khanhnm08/HK_Egg_Incubator/Image/z2520415236812_bf9dbb3cffaa10acfa7b76b04709e803.jpg

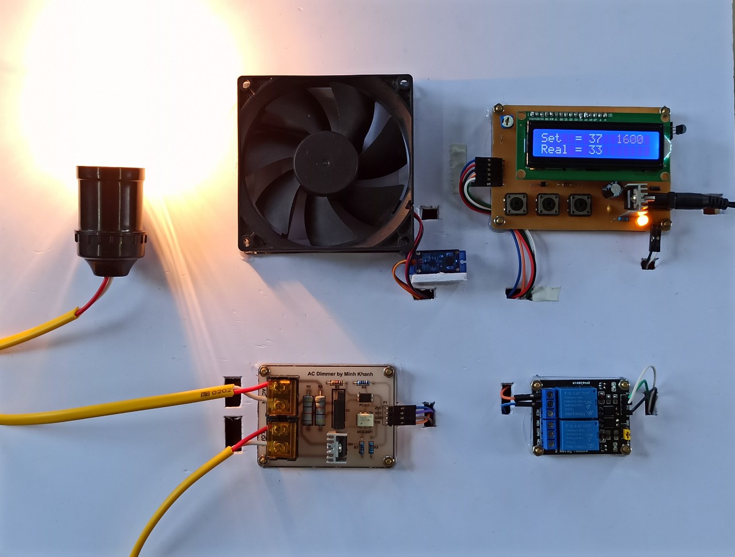
Image/z2520415236812_bf9dbb3cffaa10acfa7b76b04709e803.jpg
