khanhnm08/HK_Egg_Incubator/Image/z2520414831930_501c888e308c328f4274072a1150b6d0.jpg

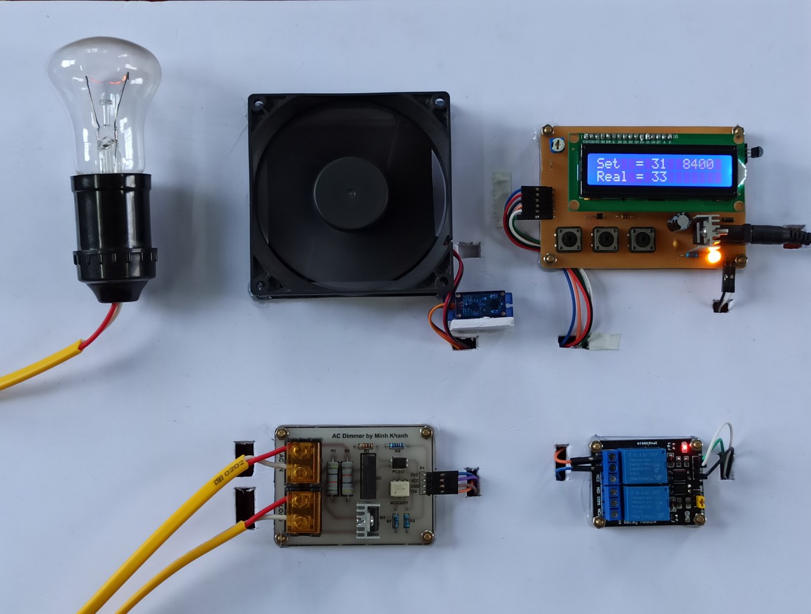
Image/z2520414831930_501c888e308c328f4274072a1150b6d0.jpg
