khanhnm08/HK_Egg_Incubator/README.md

# Điều khiển nhiệt dộ ứng dụng cho lò ấm trứng.
