khanhnm08/HK_Egg_Incubator/Slide bao cao.pptx

## Điều khiển nhiệt độ ứng dụng cho lò ấp trứng.

Ngô Minh Khánh – 18020698
Đặng Trung Hiếu – 18020498

## Nội dung

I. Mở đầu

II. Sơ lược hệ thống

III.Chi tiết các chức năng chính.

IV. Tổng kết & đánh giá

## Slide 3

I. Mở đầu.

- Đề tài hướng tới xây dựng hệ thống tự động kiểm soát nhiệt độ của lò ấp trứng. Trong thực tế hiện nay các bác nông dẫn sử dụng phương pháp truyền thống hoặc các mạch relay để làm lò ấp, các phương pháp này đem lại khả năng ổn định nhiệt độ không cao do đó nhóm chúng em đã nảy ra ý tưởng thực hiện đề tài này.

- Các yêu cầu chức năng chính:
- Đo đạc nhiệt độ.
- Hiện thị thông số nhiệt độ.
- Điều chỉnh thiết bị gia nhiệt dùng thuật toán PID số.
- Tính năng thông gió.

## Slide 4

II. Sơ lược hệ thống.

1. Sơ đồ khối thành phần hệ thống.


## Slide 5

II. Sơ lược hệ thống.

2. Mạch nguyên lý.

- Các thành phần quan trọng:
- LM35
- AC dimmer
- Relay
- Servo


## Slide 6

II. Sơ lược hệ thống.

3. Lưu đồ thuật toán tổng quát.


## Slide 7

III. Chi tiết các chức năng chính.

1. Đọc giá trị nhiệt độ LM35.

1.1. Cảm biến nhiệt độ LM35.

- LM35 là một loại cảm biến nhiệt độ bán dẫn tương tự rất phổ biến và được ứng dụng rất nhiều trong thực tế hiện nay. Nhiệt độ được xác định bằng cách đo hiệu điện thế ngõ ra và không cần căn chỉnh.
- Điện áp ngõ ra thay đổi tuyến tính: 10mV/°C


## Slide 8

III. Chi tiết các chức năng chính.

1. Đọc giá trị nhiệt độ LM35.

1.2. Chương trình.

a, Cấu hình ADC.


b, Đọc nhiệt độ.

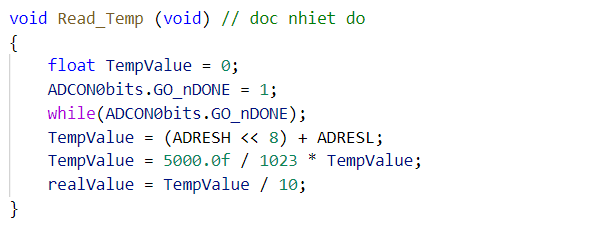
[picture p28: figure]

## Slide 9

III. Chi tiết các chức năng chính.

2. Điều chỉnh cường độ bóng đèn gia nhiệt.

2.1. Mạch AC dimmer.

a, Mạch kích Triac (Khung xanh).

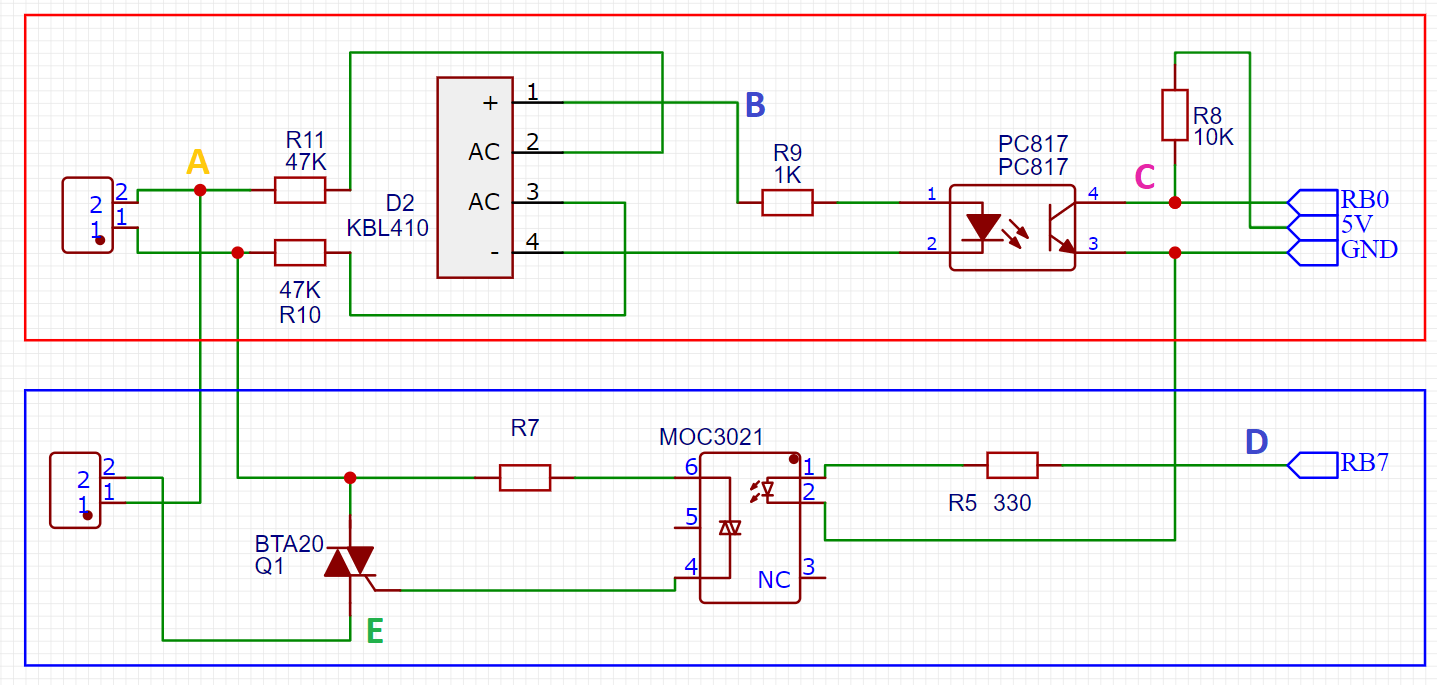
[picture p29: figure]
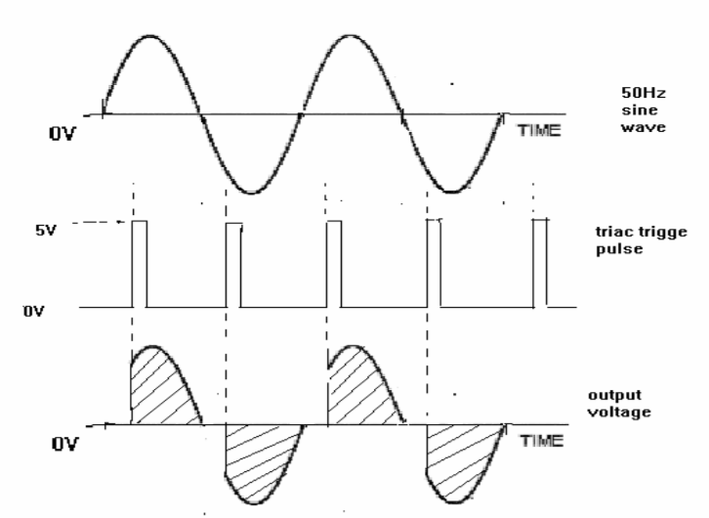
[picture p30: figure]

- Khi VĐK kích 1 ra MOC3021, diode quang trong MOC3021 sáng kích thích Diac bên trong thông, dẫn dòng điện điện từ chân T2 của Triac BTA20 đến chân G làm Triac thông.

A

AC_IN

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
LOAD

A: Điện áp xoay chiều 220V.

D: Điện áp kích Triac.

E: Dòng điện qua triac điều khiển đèn.

## Slide 10

III. Chi tiết các chức năng chính.

2. Điều chỉnh cường độ bóng đèn gia nhiệt.

2.1. Mạch AC dimmer.

b, Mạch phát hiện điểm 0 (Khung đỏ).


Tín hiệu tại C là là tín hiệu ngắt để VĐK nhận biết được điểm 0 trong nguồn điện ở đâu, đưa ra tín hiệu ổn định chính xác.

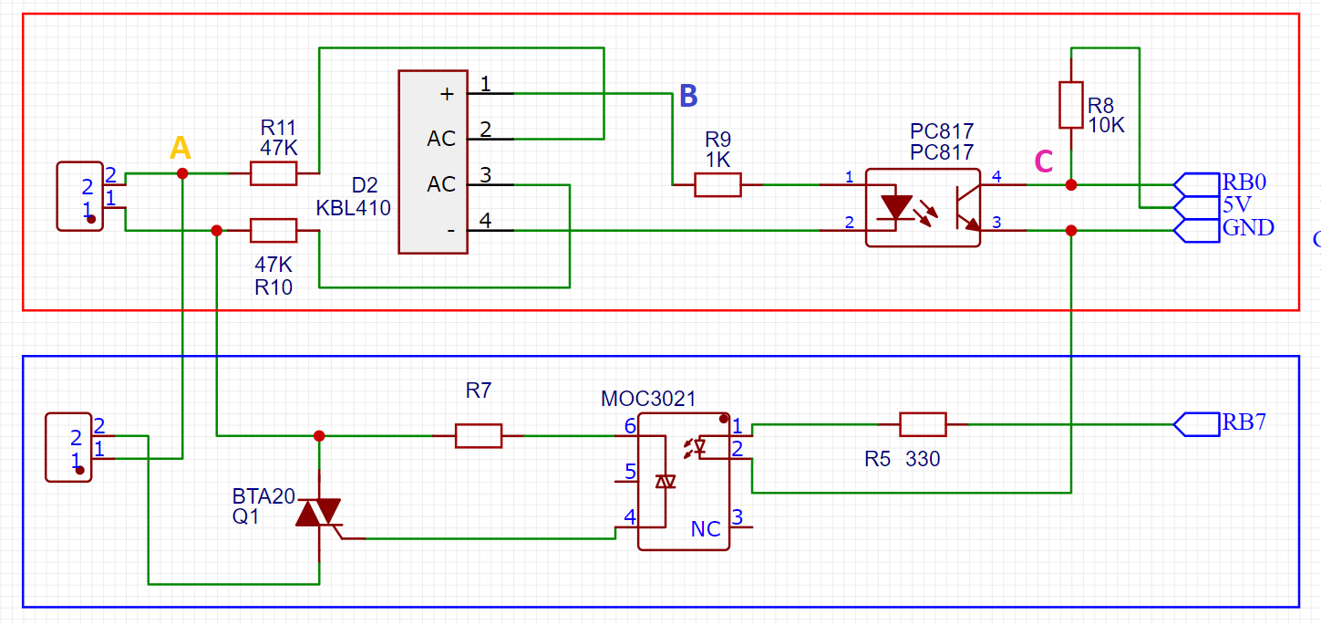
[picture p31: figure]

AC_IN

T2

T1

LOAD

G

A: Điện áp xoay chiều 220V.

B: Điện áp sau khi qua cầu diode KBL410.

C: Xung báo hiệu điểm 0.

## Slide 11

III. Chi tiết các chức năng chính.

2. Điều chỉnh cường độ bóng đèn gia nhiệt.

2.2. Chương trình.

a, Công thức PID số:

Trong đó:
- Kp: độ lợi tỉ lệ
- Ki: độ lợi tích phân
- Kd: độ lợi vi phân
- T: Thời gian lấy mẫu
- ek: Sai số của giá trị setPoint và realValue
- uk: Thông số đưa ra để điểu khiển.

*Trích từ slide bài giảng PID số, TS. Phạm Duy Hưng – UET, VNU.

## Slide 12

III. Chi tiết các chức năng chính.

2. Điều chỉnh cường độ bóng đèn gia nhiệt.

2.2. Chương trình.

b, Code.

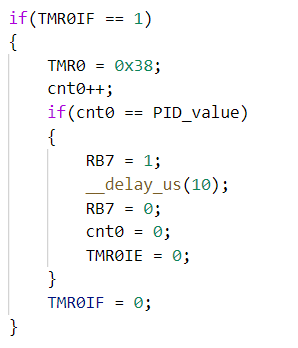
[picture p32: figure]

3. Timer 0 được cài đặt interrupt mỗi 100us. Khi cnt0 đạt giá trị bằng PID_value, kích Triac và Disable Timer 0.

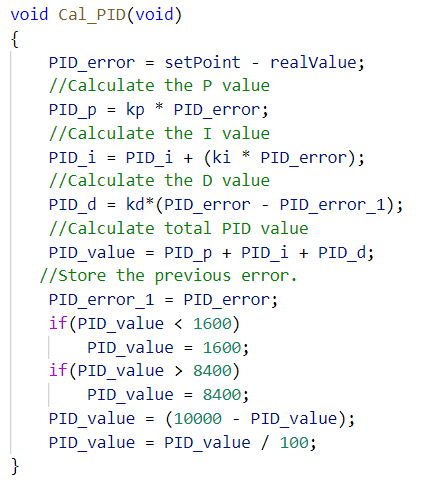
[picture p33: figure]

1. Tính lại giá trị PID sau mỗi 1s (sử dụng timer 2 lấy mẫu).
*Nửa chu kỳ điện xoay chiều có thời gian là 1000us.

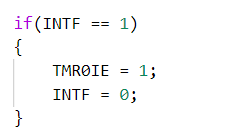
[picture p34: figure]

2. Enable Timer 0 khi phát hiện điểm 0.

## Slide 13

III. Chi tiết các chức năng chính.

3. Điều khiển quạt thông gió.

3.1. Mạch relay.

- RB6 = 0, Q2 thông, dòng điện qua cuộn dây, gây ra lực từ hút chân COM từ NC chuyển sang NO.

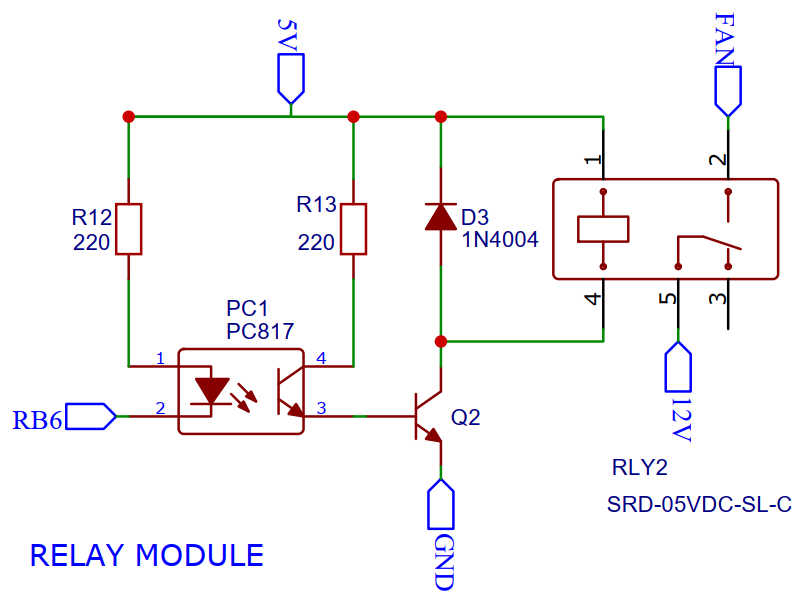
[picture p35: figure]

## Slide 14

III. Chi tiết các chức năng chính.

3. Điều khiển quạt thông gió.

3.2. Chương trình.

a, Cấu hình OUTPUT cho chân RB6.

b, Bật/tắt relay theo điều kiện.

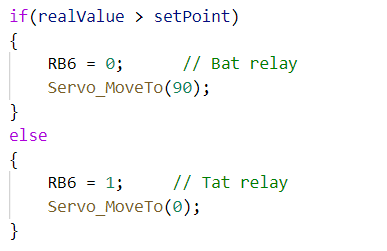
[picture p36: figure]

## Slide 15

III. Chi tiết các chức năng chính.

4. Điều khiển cửa thông gió.

4.1. Nguyên lý servo.

- Servo SG90 được điều khiển bằng băm xung. Tùy thuộc vào duty cycle, mà servo quay góc khác nhau.


## Slide 16

III. Chi tiết các chức năng chính.

4. Điều khiển cửa thông gió.

4.2. Chương trình.

- Đặt vấn đề.

Với Fosc = 16MHz, PR2 = 255 (8bit), Timer2 prescale (max) = 16. Tpwm = 1ms << 20ms. ==> Sử dụng Compare mode.

- Cài đặt chu kỳ bằng Timer 1

- SG90 có chu kỳ 20ms
- Tần số thạch anh = 16MHz => Tần số PIC, f = 4MHz
- Chọn prescale = 1:4
- Chu kỳ cho 1 tick = 1/(f/4) = 1us
- Cần tạo ra 20ms, ta cần 20000 tick
- Đặt preload cho Timer 1 = 65536 – 20000 = 45536 (0xB1E6)

- Điều chỉnh duty bằng CCPR1.

- Khi giá trị trên Timer 1 = CCPR1 -> RC2 =0.
- Servo quay góc 0 độ: CPPR1 = 0xB430.
- Servo quay góc 90 độ: CCPR1 = 0xB7A8.

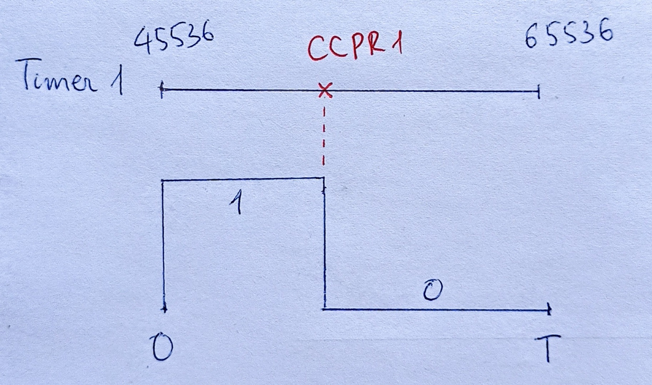
[picture p37: figure]

RC2

## Slide 17

III. Chi tiết các chức năng chính.

4. Điều khiển cửa thông gió.

4.2. Chương trình.

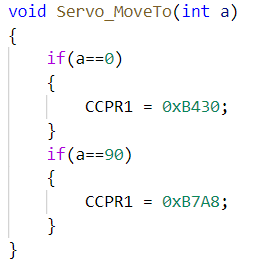
[picture p38: figure]

3. Điều chỉnh duty cycle.

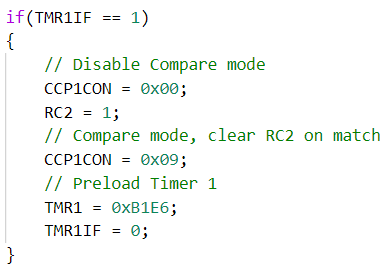
[picture p39: figure]

4. Đặt RC2 lên 1, preload lại Timer 1, đặt lại chế độ compare khi kết thúc 1 chu kỳ (Timer 1 interrupt)

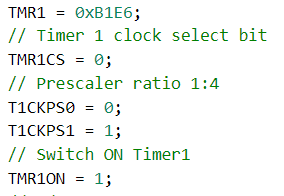
[picture p40: figure]

1. Cấu hình Timer 1
Tạo chu kỳ 20ms.

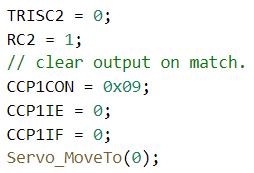
[picture p41: figure]

2. Cấu hình cho compare mode.
Xóa RC2 về 0 khi gí trị trên Timer 1 = CCPR1.

## Slide 18

IV. Tổng kết & đánh giá.

1.Demo video.

## Slide 19

IV. Tổng kết & đánh giá.

2. Đáp ứng hệ thống.

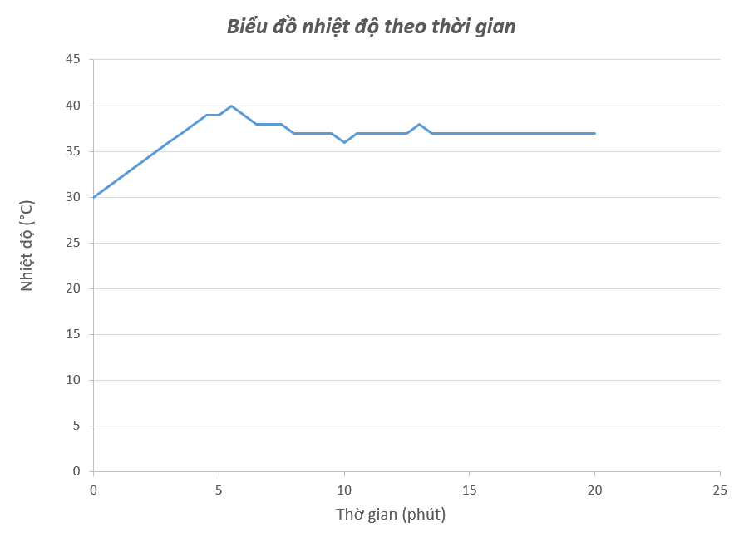
[picture p42: figure]

Đáp ứng hệ thống với nhiệt độ cài đặt 37°C và nhiệt độ ban đầu 30°C.

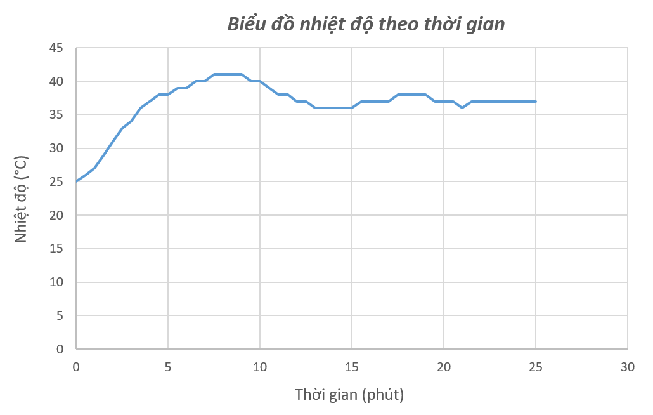
[picture p43: figure]

Đáp ứng hệ thống với nhiệt độ cài đặt 37°C nhiệt độ ban đầu 25°C.

## Slide 20

IV. Tổng kết & đánh giá.

3. Đánh giá.

- Ưu điểm:
- Hệ thộng hoạt động ổn định.
- Khả năng ổn định nhiệt độ tốt hơn so với phương pháp truyền thống (cắm bóng điện) và điều khiển on/off bằng relay.
- Nhược điểm:
- Cần thiết kế lại mạch để áp dụng trực tiếp vào thực tiễn.
- Cần khảo sát thêm giá trị PID để ổn định với khoảng chênh lệch nhiệt độ lớn hơn.

## Slide 21

THANK YOU!

Github: https://github.com/KhanhNgo19/HK_Egg_Incubator

## Slide 22

## Light Bulb Infographics

It’s a gas giant and also the biggest planet in the Solar System

Saturn is the ringed one. It’s composed mostly of hydrogen and helium

It has a beautiful name, but it’s terribly hot, even more than Mercury

Mercury is the closest planet to the Sun and the smallest one

Mars is actually a cold place. It’s a planet full of iron oxide dust

Neptune is the farthest planet from the Sun and the fourth-largest

## Light Bulb Infographics

Jupiter is a gas giant and actually also the biggest planet in the Solar System. It is the fourth-brightest object in the sky

1

2

Saturn is a gas giant in the Solar System, composed mostly of hydrogen and helium.
Yes, this is the ringed one

Venus has a beautiful name and is the second planet from the Sun. It’s terribly hot and its atmosphere is extremely poisonous

3

## Light Bulb Infographics

Mercury is the smallest planet in the Solar System

01

Jupiter is the biggest planet in the Solar System

02

Saturn is composed mostly of hydrogen and helium

03

Mars is actually a cold place. It’s full of iron oxide dust

04

## Light Bulb Infographics

It is the smallest planet in
the Solar System

Mercury

It is composed mostly of
hydrogen and helium

Saturn

It has a beautiful name,
but it is terribly hot

Venus

It is the biggest planet
in the Solar System

Jupiter

It is actually a cold place.
It’s full of iron oxide dust

Mars

## Light Bulb Infographics

01

Jupiter is the biggest planet in the Solar System

02

Mercury is the closest planet
to the Sun

03

Venus has a beautiful name, also high temperatures

04

Saturn is composed mostly of hydrogen and helium

05

Despite being red, Mars is actually
a cold place

## Light Bulb Infographics

Jupiter is the biggest planet in the Solar System

Saturn is composed mostly of hydrogen and helium

Venus has a beautiful name, also high temperatures

Despite being red, Mars is actually
a cold place

## Light Bulb Infographics

Jupiter is a gas giant and the biggest planet in the Solar System. It’s the fourth-brightest object in the sky

Saturn is a gas giant in the Solar System, composed mostly of hydrogen and helium. Yes, It’s the ringed one

Venus has a beautiful name, but it’s terribly hot. It’s the second planet from the Sun in the Solar System

## Light Bulb Infographics

01

04

02

03

Jupiter is a gas giant and also the biggest planet in the Solar System

It has a beautiful name, but it’s terribly hot, even hotter than Mercury

Mars is actually a cold place. It’s a planet full of iron oxide dust

It’s the smallest and closest planet to the Sun in the Solar System

## Light Bulb Infographics

Saturn is a gas giant in the Solar System, composed of hydrogen and helium

Venus has a beautiful name, and is the second planet from the Sun

Despite being red, Mars is actually a cold place. It’s full of iron oxide dust

Jupiter is a gas giant and actually also the biggest planet in the Solar System

## Light Bulb Infographics

It’s a gas giant and also the biggest planet in the Solar System

Saturn is the ringed one. It’s composed mostly of hydrogen and helium

It has a beautiful name, but it’s terribly hot, even more than Mercury

Mercury is the closest planet to the Sun and the smallest one

Mars is actually a cold place. It’s a planet full of iron oxide dust

It has a beautiful name and is the second planet from the Sun

## Light Bulb Infographics

Mercury is the closest planet to the Sun and the smallest one

Saturn is composed of hydrogen and helium. It’s the ringed one

Venus has the most beautiful name and is the second planet

Mars is actually a cold place. It’s a planet full of iron oxide dust

## Light Bulb Infographics

Mercury is the smallest planet in the Solar System

Saturn is a gas giant and has several rings

Mercury is the smallest planet in the Solar System

Saturn is a gas giant and has several rings

Venus has the most beautiful name

Venus has the most beautiful name

## Light Bulb Infographics

Jupiter is the biggest planet in the Solar System

Venus has a beautiful name,
but it’s terribly hot

Mercury is the smallest planet in the Solar System

Saturn is composed of
hydrogen and helium

## Light Bulb Infographics

Mercury

Mercury is the closest planet to the Sun and smallest one

Venus

Venus has a beautiful name and is the second planet from the Sun

Jupiter

Jupiter is a gas giant. It’s the biggest planet in the Solar System

Mars

Mars is actually a cold place. This planet is full of iron oxide dust

## Light Bulb Infographics

Jupiter

Jupiter is the biggest planet in the Solar System

Mercury

Mercury is the smallest planet in the Solar System

Neptune

Neptune is the farthest planet from the Sun

## Light Bulb Infographics

1

Jupiter is a gas giant and also the
biggest planet in the Solar System

2

Saturn is a gas giant and composed
mostly of hydrogen and helium

3

Venus has a beautiful name and is the second planet from the Sun

4

Despite being red, Mars is actually
a cold place. It’s full of iron oxide dust

## Light Bulb Infographics

Mercury is the closest planet to the Sun and the smallest one in the Solar System

Despite being red, Mars is actually a cold place. It’s full of iron oxide dust

Saturn is the ringed one. It’s composed of hydrogen and helium

Jupiter is a gas giant and the biggest planet in the Solar System

It has a beautiful name and is the second planet from the Sun

## Light Bulb Infographics

Despite being red, Mars is a cold place. It’s full of iron oxide dust, giving the planet its reddish cast

Venus has a beautiful name, but it’s terribly hot and its atmosphere is poisonous

Mercury is the closest planet to the Sun and the smallest one in the Solar System

Jupiter is a gas giant and the fourth-brightest object in the night sky

Saturn is a gas giant and ringed one and it is composed mostly of hydrogen and helium

## Light Bulb Infographics

Mercury is the smallest planet

Neptune is the farthest planet

Saturn has several rings

Jupiter is the biggest planet

Venus has a beautiful name

Mars is actually
a cold place

Earth is where we live on

## Light Bulb Infographics

Mercury is the closest to the Sun

Jupiter is the biggest planet

Neptune is the farthest planet

## Light Bulb Infographics

1

Jupiter is the biggest planet in the Solar System

2

Mercury is the closest planet
to the Sun

3

Venus has a beautiful name, also high temperatures

## Light Bulb Infographics

Jupiter is a gas giant and actually also the biggest planet in the Solar System

Despite being red, Mars is actually a cold place. It’s full of iron oxide

Saturn is a gas giant in the Solar System, composed of hydrogen and helium

Venus has a beautiful name, but it’s the hottest planet in the Solar System

## Light Bulb Infographics

Saturn is the ringed one. It’s composed mostly
of hydrogen and helium

It’s a gas giant and also the biggest
planet in the Solar System

It has a beautiful name, but it’s
terribly hot, even more than Mercury

Mars is actually a cold place.
It’s a planet full of iron oxide dust

It’s the smallest and closest
planet to the Sun in the Solar System

## Light Bulb Infographics

It’s the smallest planet in the Solar System

It’s composed mostly of hydrogen and helium

Neptune is the farthest planet from the Sun

It’s the biggest planet in the Solar System

Venus has a very poisonous atmosphere

It’s a cold place. It’s full of iron oxide dust

## Light Bulb Infographics

It’s the cutest and smallest planet in
the Solar System

It’s a gas giant. It’s composed mostly of hydrogen and helium

Venus has a beautiful name, but also very high temperatures

It is the biggest and most wonderful planet of them all

## Light Bulb Infographics

1

Venus has a beautiful name, but it’s the hottest and
the second planet in the Solar System

2

Jupiter it’s a gas giant and also the biggest and the most wonderful planet in the Solar System

3

Saturn is a gas giant, the ringed one and a wonderful planet. It’s composed mostly of hydrogen and helium

4

Mercury is the closest planet to the Sun and the smallest one in the Solar System

## Light Bulb Infographics

It’s a gas giant and also the biggest planet in the Solar System

Mars is actually a cold place. It’s a planet full of iron oxide dust

It has a beautiful name, but it’s terribly hot, even more than Mercury

Saturn is the ringed one. It’s composed mostly of hydrogen and helium

## Instructions for use (free users)

In order to use this template, you must credit Slidesgo (http://bit.ly/2PfT4lq) by keeping the Thanks slide.
You are allowed to:
- Modify this template.
- Use it for both personal and commercial purposes.
You are not allowed to:
- Sublicense, sell or rent any of Slidesgo Content (or a modified version of Slidesgo Content).
- Distribute this Slidesgo Template (or a modified version of this Slidesgo Template) or include it in a database or in any other product or service that offers downloadable images, icons or presentations that may be subject to distribution or resale.
- Use any of the elements that are part of this Slidesgo Template in an isolated and separated way from this Template.
- Delete the “Thanks” or “Credits” slide.
- Register any of the elements that are part of this template as a trademark or logo, or register it as a work in an intellectual property registry or similar.

For more information about editing slides, please read our FAQs or visit Slidesgo School:
https://slidesgo.com/faqs (http://bit.ly/33VAFh3) and https://slidesgo.com/slidesgo-school (http://bit.ly/30B07Gq)

## Instructions for use (premium users)

In order to use this template, you must be a Premium user on Slidesgo (http://bit.ly/2PfT4lq).
You are allowed to:
- Modify this template.
- Use it for both personal and commercial purposes.
- Hide or delete the “Thanks” slide and the mention to Slidesgo in the credits.
- Share this template in an editable format with people who are not part of your team.
You are not allowed to:
- Sublicense, sell or rent this Slidesgo Template (or a modified version of this Slidesgo Template).
- Distribute this Slidesgo Template (or a modified version of this Slidesgo Template) or include it in a database or in any other product or service that offers downloadable images, icons or presentations that may be subject to distribution or resale.
- Use any of the elements that are part of this Slidesgo Template in an isolated and separated way from this Template.
- Register any of the elements that are part of this template as a trademark or logo, or register it as a work in an intellectual property registry or similar.

For more information about editing slides, please read our FAQs or visit Slidesgo School:
https://slidesgo.com/faqs (http://bit.ly/33VAFh3) and https://slidesgo.com/slidesgo-school (http://bit.ly/30B07Gq)

## Infographics

You can add and edit some i (https://bit.ly/2ZjL1pd)nfographics (https://bit.ly/2ZjL1pd) to your presentation to present your data in a visual way.

- Choose your favourite infographic and insert it in your presentation using Ctrl C + Ctrl V or Cmd C + Cmd V in Mac.
- Select one of the parts and ungroup it by right-clicking and choosing “Ungroup”.
- Change the color by clicking on the paint bucket.
- Then resize the element by clicking and dragging one of the square-shaped points of its bounding box (the cursor should look like a double-headed arrow). Remember to hold Shift while dragging to keep the proportions.
- Group the elements again by selecting them, right-clicking and choosing “Group”.
- Repeat the steps above with the other parts and when you’re done editing, copy the end result and paste it into your presentation.
- Remember to choose the “Keep source formatting” option so that it keeps the design. For more info, please visit Slidesgo School (http://bit.ly/30B07Gq).
