khanhnm08/HK_Egg_Incubator/Image/7805.png

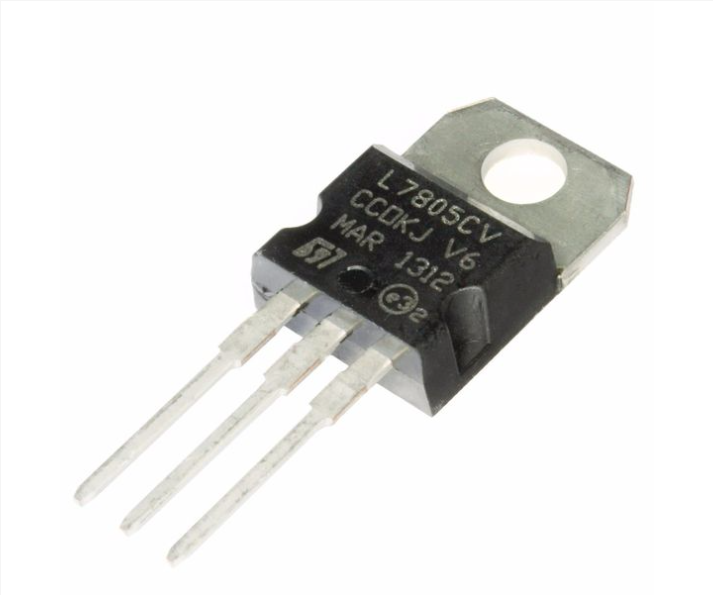
Image/7805.png
