khanhnm08/HK_Egg_Incubator/Image/7805_to-220_master.jpg

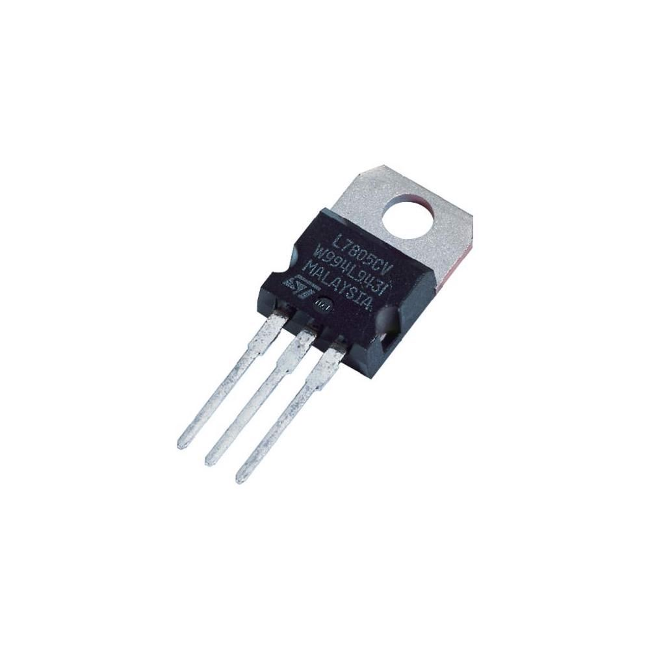
Image/7805_to-220_master.jpg
