khanhnm08/HK_Egg_Incubator/Image/AC_Dimmer - Copy.png

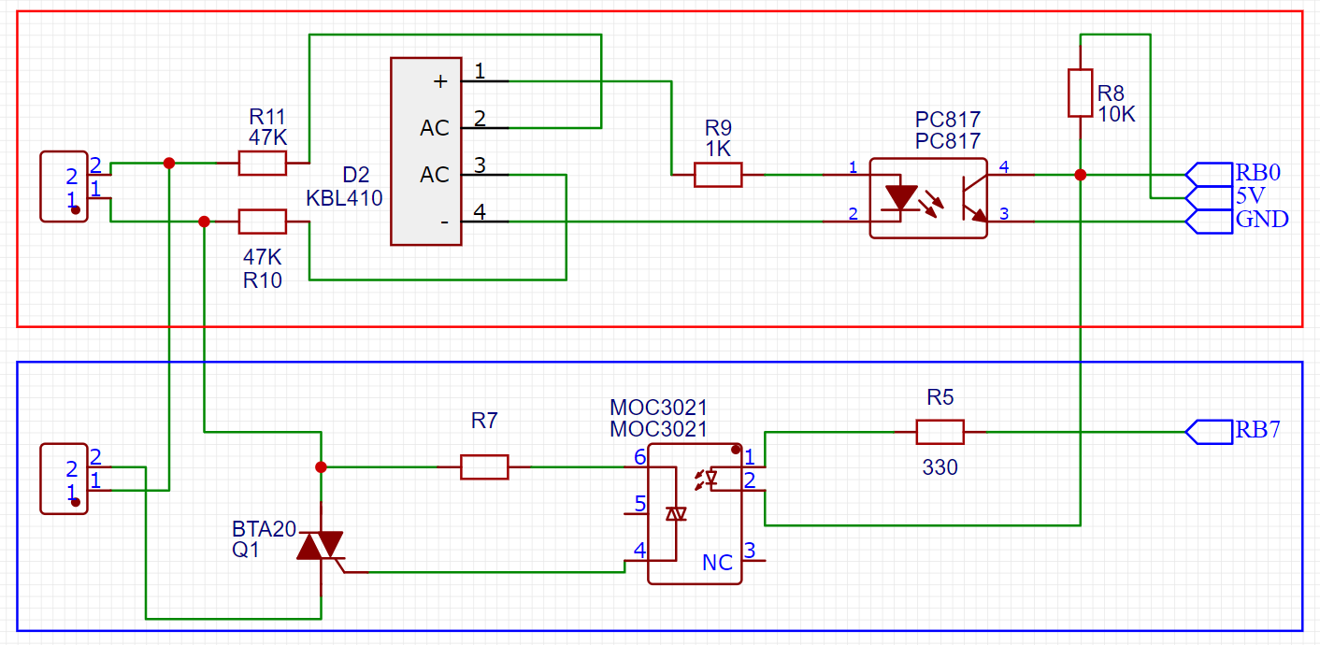
Image/AC_Dimmer - Copy.png
