khanhnm08/HK_Egg_Incubator/Image/adapter 12v.jpg

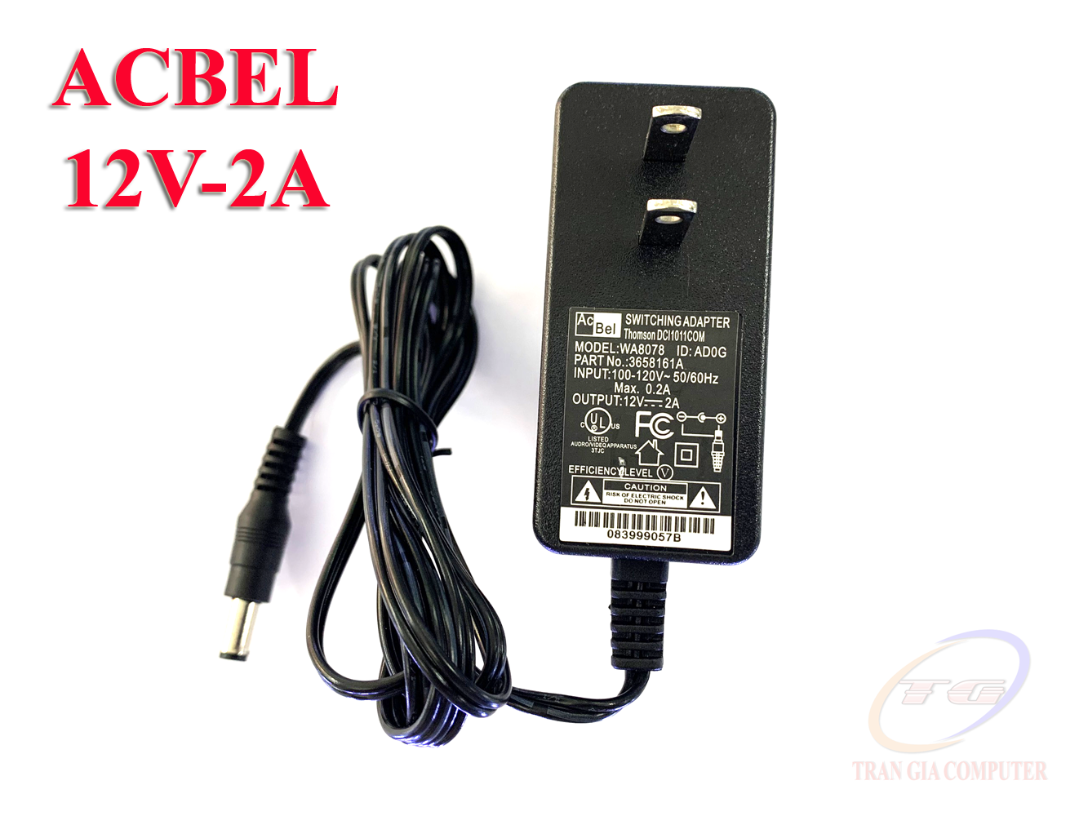
Image/adapter 12v.jpg
