khanhnm08/HK_Egg_Incubator/Image/f.jpg

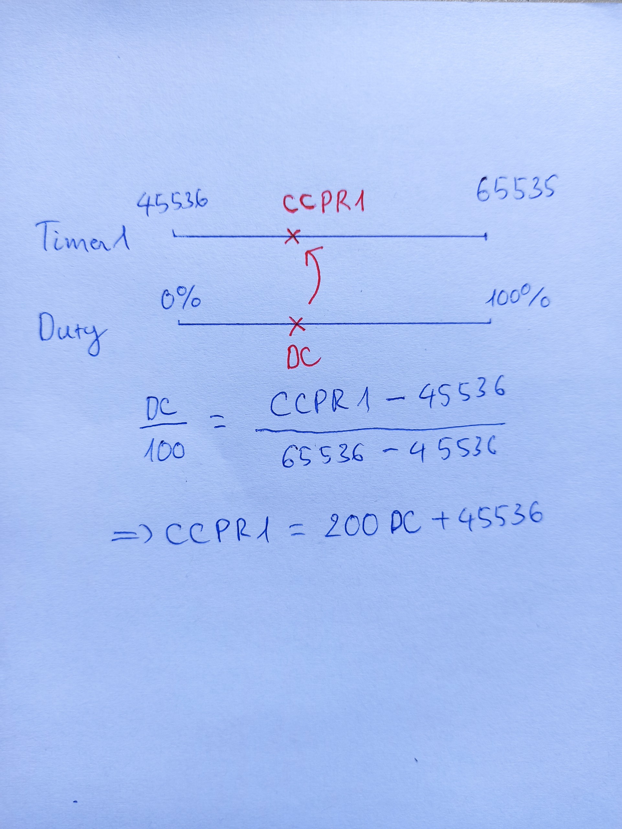
Image/f.jpg
