khanhnm08/HK_Egg_Incubator/Image/half-phase-control.jpg

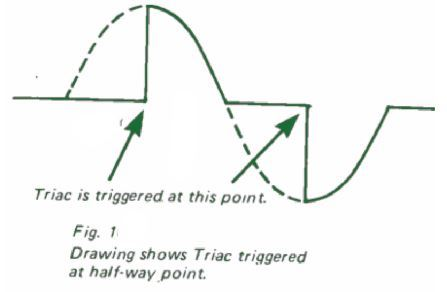
Image/half-phase-control.jpg
