khanhnm08/HK_Egg_Incubator/Image/pid3.png

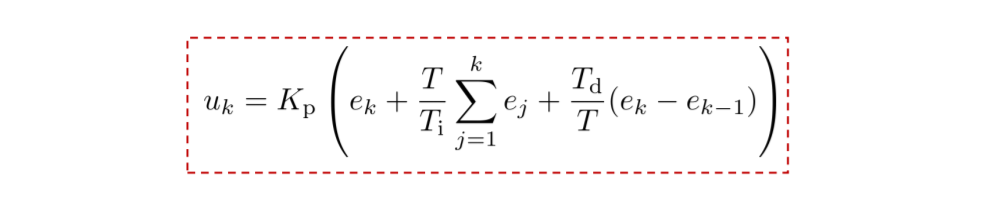
Image/pid3.png
