khanhnm08/HK_Egg_Incubator/Schematic/2.PIC16F877A_LCD_LM35.pdf

16x2

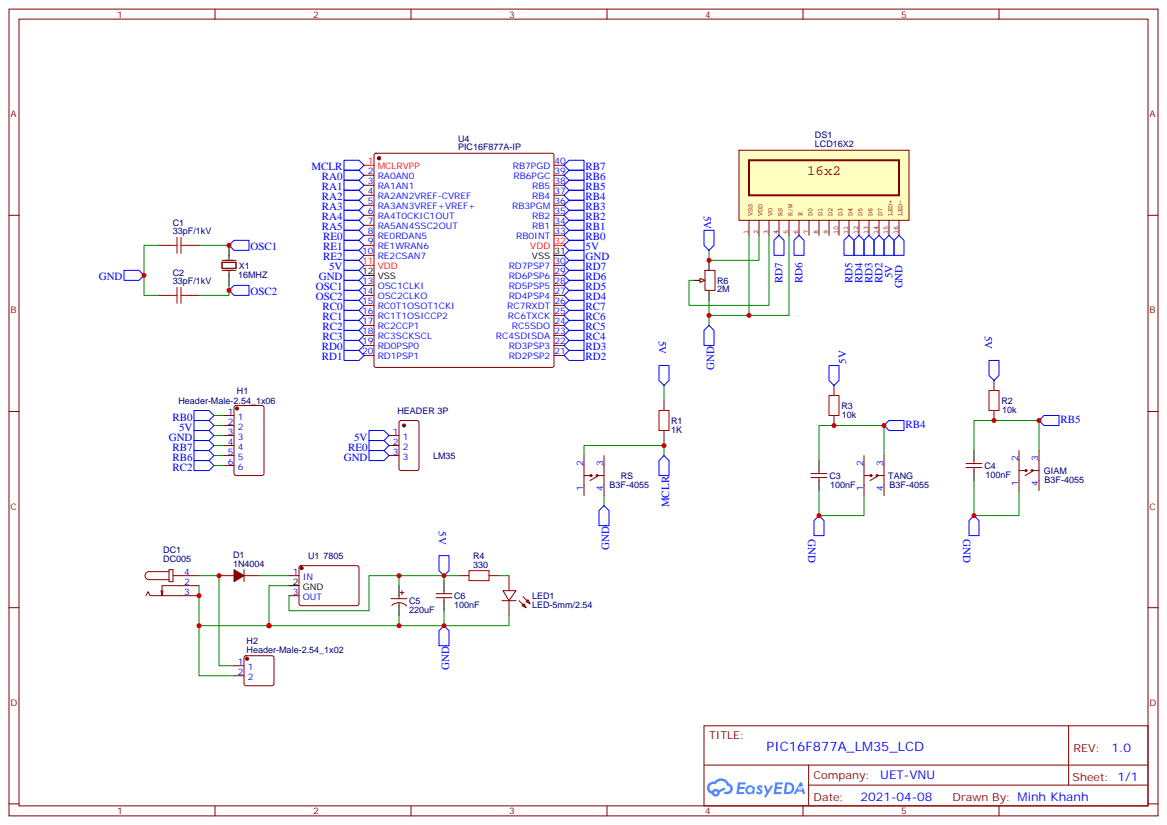
[picture p51: page 1]

Drawn By: Minh Khanh
