khanhnm08/HK_Egg_Incubator/Schematic/1.Egg_Incubator.pdf

16x2

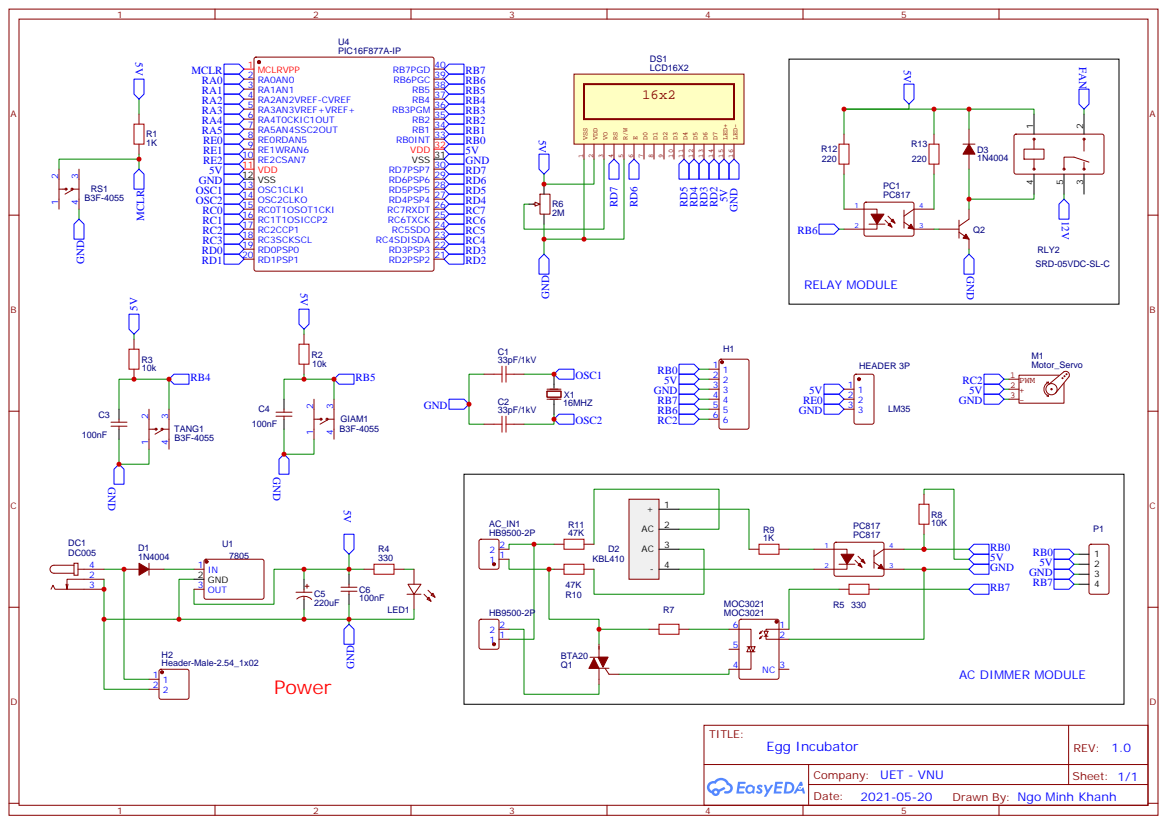
[picture p52: page 1]

Drawn By: Ngo Minh Khanh
