khanhnm08/HK_Egg_Incubator/Schematic/3.AC_Dimmer_Module.pdf

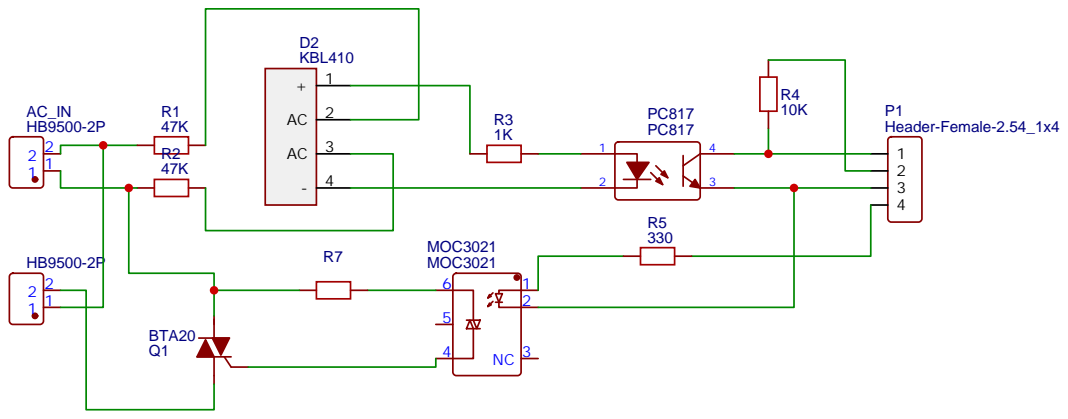
[picture p53: page 1]
