khanhnm08/HK_Egg_Incubator/Schematic/Schematic_Egg Incubator.pdf

16x2

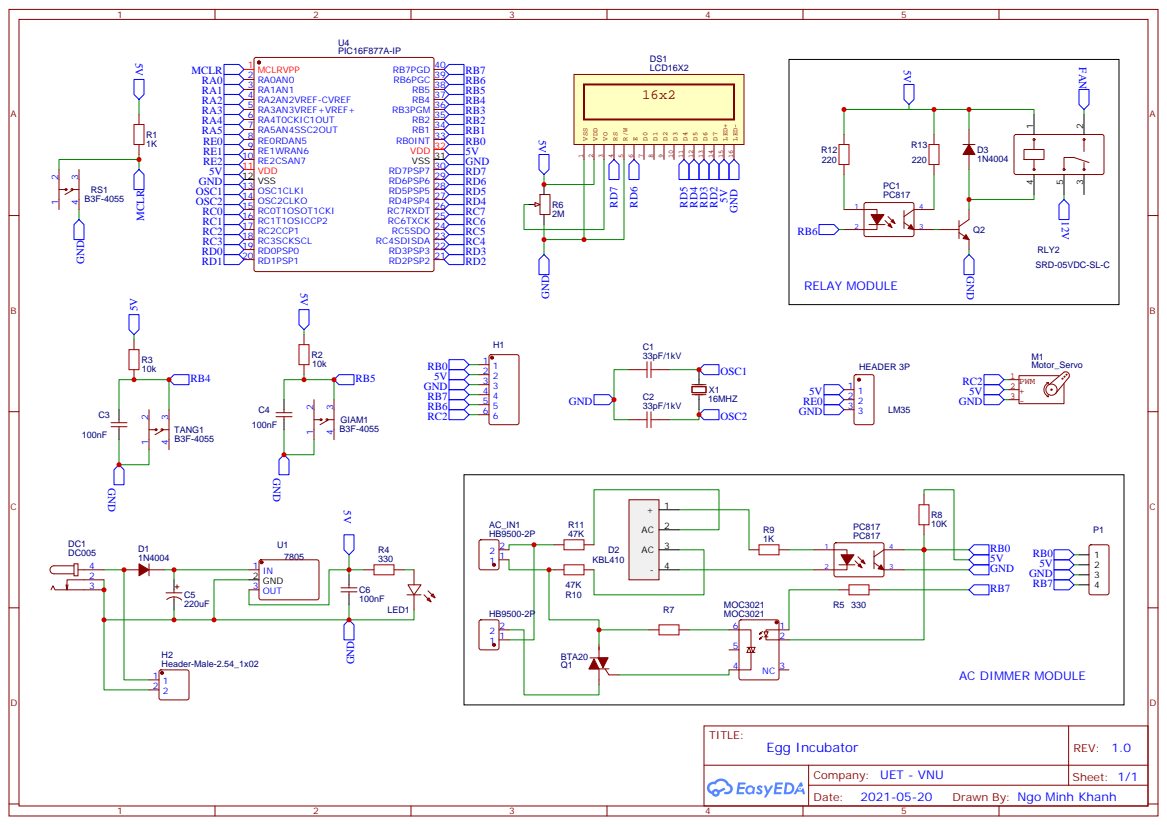
[picture p54: page 1]

Drawn By: Ngo Minh Khanh
