khanhnm08/HK_Egg_Incubator/(list of files, drawings)

Other design files:
Incubator.pdsprj
PCB/AC_Dimmer_Module.pcbdoc
PCB/PIC16F877A_LM35_LCD.pcbdoc
PCB/PIC16F877A_LM35_LCD_PCB.pcbdoc
